sharkbonebroth/li-ion_BMS/li-ion_BMS_PCB/li-ion_BMS_kicadLib/3D/SMD WS2812B Mini.step

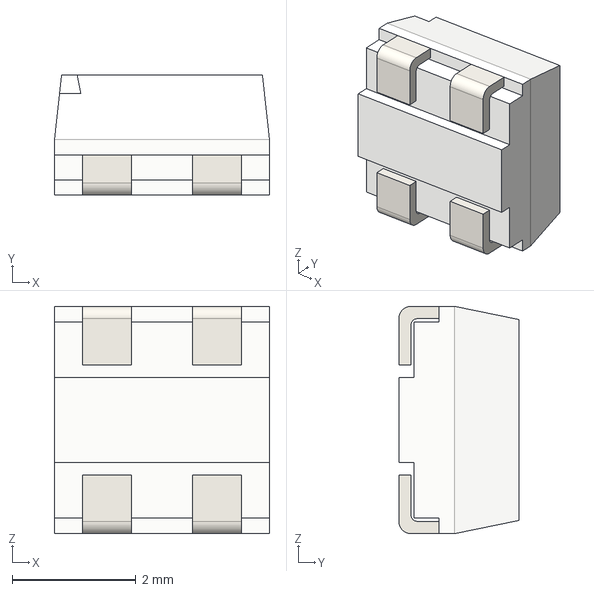
[picture p1: CAD file, 2025-04-25]
li-ion_BMS_PCB/li-ion_BMS_kicadLib/3D/SMD WS2812B Mini.step
3.48 x 1.95 x 3.68 mm
