sharkbonebroth/li-ion_BMS/li-ion_BMS_PCB/li-ion_BMS_PCB.kicad_pcb

## KiCad design li-ion_BMS_PCB/li-ion_BMS_PCB.kicad_pcb (2025-04-29)

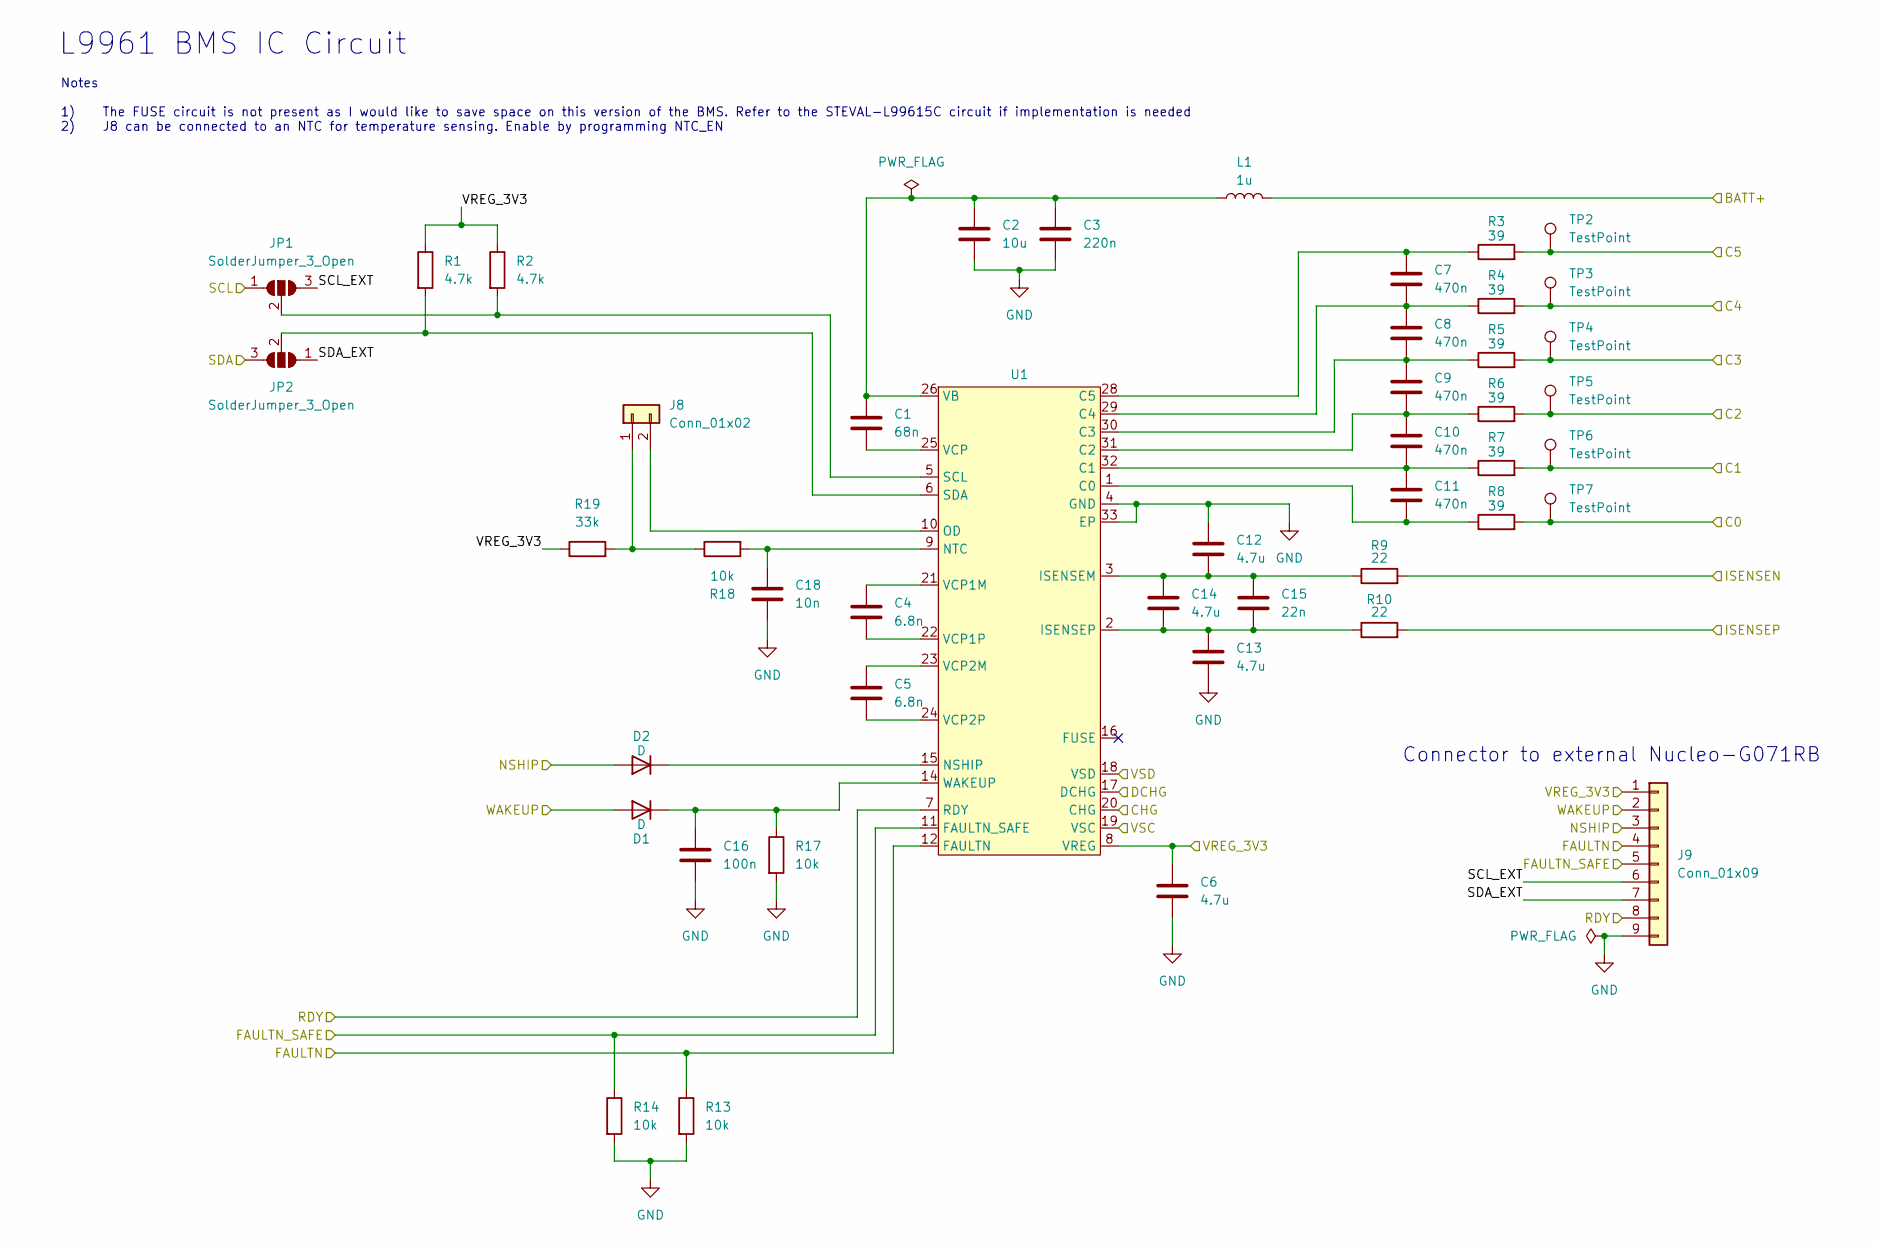
[picture p2: schematic BMS_IC_Circuit.kicad_sch]

Parts:
C1: 68n; C_0603_1608Metric; LCSC C31658
C2: 10u; C_0805_2012Metric; LCSC C440198
C3: 220n; C_0805_2012Metric; LCSC C5378
C4, C5: 6.8n; C_0402_1005Metric; LCSC C1542
C6, C12, C13, C14: 4.7u; C_0603_1608Metric; LCSC C19666
C7, C8, C9, C10, C11: 470n; C_0603_1608Metric; LCSC C1623
C15: 22n; C_0603_1608Metric; LCSC C21122
C16: 100n; C_0603_1608Metric; LCSC C14663
C18: 10n; C_0402_1005Metric; LCSC C15195
D1, D2: D; SS34; LCSC C8678
J8: Conn_01x02; JST_GH_SM02B-GHS-TB_1x02-1MP_P1.25mm_Horizontal; LCSC C189893
J9: Conn_01x09; PinHeader_1x09_P2.54mm_Vertical
JP1, JP2: SolderJumper_3_Open; SolderJumper-3_P1.3mm_Open_Pad1.0x1.5mm_NumberLabels
L1: 1u; L_1008_2520Metric; LCSC C86091
R1, R2: 4.7k; R_0402_1005Metric; LCSC C25900
R3, R4, R5, R6, R7, R8: 39; R_1206_3216Metric; LCSC C22198
R9, R10: 22; R_0603_1608Metric; LCSC C23345
R13, R14, R17, R18: 10k; R_0402_1005Metric; LCSC C25744
R19: 33k; R_0402_1005Metric; LCSC C25779
TP2, TP3, TP4, TP5, TP6, TP7: TestPoint; TestPoint_Pad_D1.0mm
U1: QFN50P500X500X100-33N-D

Connections:
/BMS_IC_Circuit/BATT+: L1.2, U1.19 (VSC); also elsewhere on the board
/BMS_IC_Circuit/C0: R8.2, TP7.1; also elsewhere on the board
/BMS_IC_Circuit/C1: R7.2, TP6.1; also elsewhere on the board
/BMS_IC_Circuit/C2: R6.2, TP5.1; also elsewhere on the board
/BMS_IC_Circuit/C3: R5.2, TP4.1; also elsewhere on the board
/BMS_IC_Circuit/C4: R4.2, TP3.1; also elsewhere on the board
/BMS_IC_Circuit/C5: R3.2, TP2.1; also elsewhere on the board
/BMS_IC_Circuit/CHG: U1.20 (CHG); also elsewhere on the board
/BMS_IC_Circuit/DCHG: U1.17 (DCHG); also elsewhere on the board
/BMS_IC_Circuit/FAULTN: J9.4, R13.1, U1.12 (FAULTN); also elsewhere on the board
/BMS_IC_Circuit/FAULTN_SAFE: J9.5, R14.1, U1.11 (FAULTN_SAFE); also elsewhere on the board
/BMS_IC_Circuit/NSHIP: D2.2 (A), J9.3; also elsewhere on the board
/BMS_IC_Circuit/RDY: J9.8, U1.7 (RDY); also elsewhere on the board
/BMS_IC_Circuit/SCL: JP1.1 (A); also elsewhere on the board
/BMS_IC_Circuit/SCL_EXT: J9.6, JP1.3 (B)
/BMS_IC_Circuit/SDA: JP2.3 (B); also elsewhere on the board
/BMS_IC_Circuit/SDA_EXT: J9.7, JP2.1 (A)
/BMS_IC_Circuit/VREG_3V3: C6.1, J9.1, R1.1, R2.1, R19.1, U1.8 (VREG); also elsewhere on the board
/BMS_IC_Circuit/WAKEUP: D1.2 (A), J9.2; also elsewhere on the board
/Battery_Interfacing_Circuit/CHG/DCHG+: U1.18 (VSD); also elsewhere on the board
/Battery_Interfacing_Circuit/CHG/DCHG-: R10.2; also elsewhere on the board
GND: C2.2, C3.2, C6.2, C12.1, C13.2, C16.2, C18.2, J9.9, R9.2, R13.2, R14.2, R17.2, U1.4 (GND), U1.13 (GND), U1.27 (GND), U1.33 (EP); also elsewhere on the board
unnamed: C16.1, D1.1 (K), R17.1, U1.14 (WAKEUP)
unnamed: D2.1 (K), U1.15 (NSHIP)
unnamed: J8.1, R18.1, R19.2
unnamed: J8.2, U1.10 (OD)
unnamed: JP1.2 (C), R2.2, U1.5 (SCL)
unnamed: JP2.2 (C), R1.2, U1.6 (SDA)
unnamed: C11.2, R8.1, U1.1 (C0)
unnamed: C10.2, C11.1, R7.1, U1.32 (C1)
unnamed: C9.2, C10.1, R6.1, U1.31 (C2)
unnamed: C8.2, C9.1, R5.1, U1.30 (C3)
unnamed: C7.2, C8.1, R4.1, U1.29 (C4)
unnamed: C7.1, R3.1, U1.28 (C5)
unnamed: C12.2, C14.1, C15.1, R9.1, U1.3 (ISENSEM)
unnamed: C13.1, C14.2, C15.2, R10.1, U1.2 (ISENSEP)
unnamed: C18.1, R18.2, U1.9 (NTC)
unnamed: C1.1, C2.1, C3.1, L1.1, U1.26 (VB)
unnamed: C4.1, U1.21 (VCP1M)
unnamed: C4.2, U1.22 (VCP1P)
unnamed: C5.1, U1.23 (VCP2M)
unnamed: C5.2, U1.24 (VCP2P)
unnamed: C1.2, U1.25 (VCP)

Notes on the sheet:
L9961 BMS IC Circuit
Notes 1) The FUSE circuit is not present as I would like to save space on this version of the BMS. Refer to the STEVAL-L99615C circuit if implementation is needed 2) J8 can be connected to an NTC for temperature sensing. Enable by programming NTC_EN
Connector to external Nucleo-G071RB

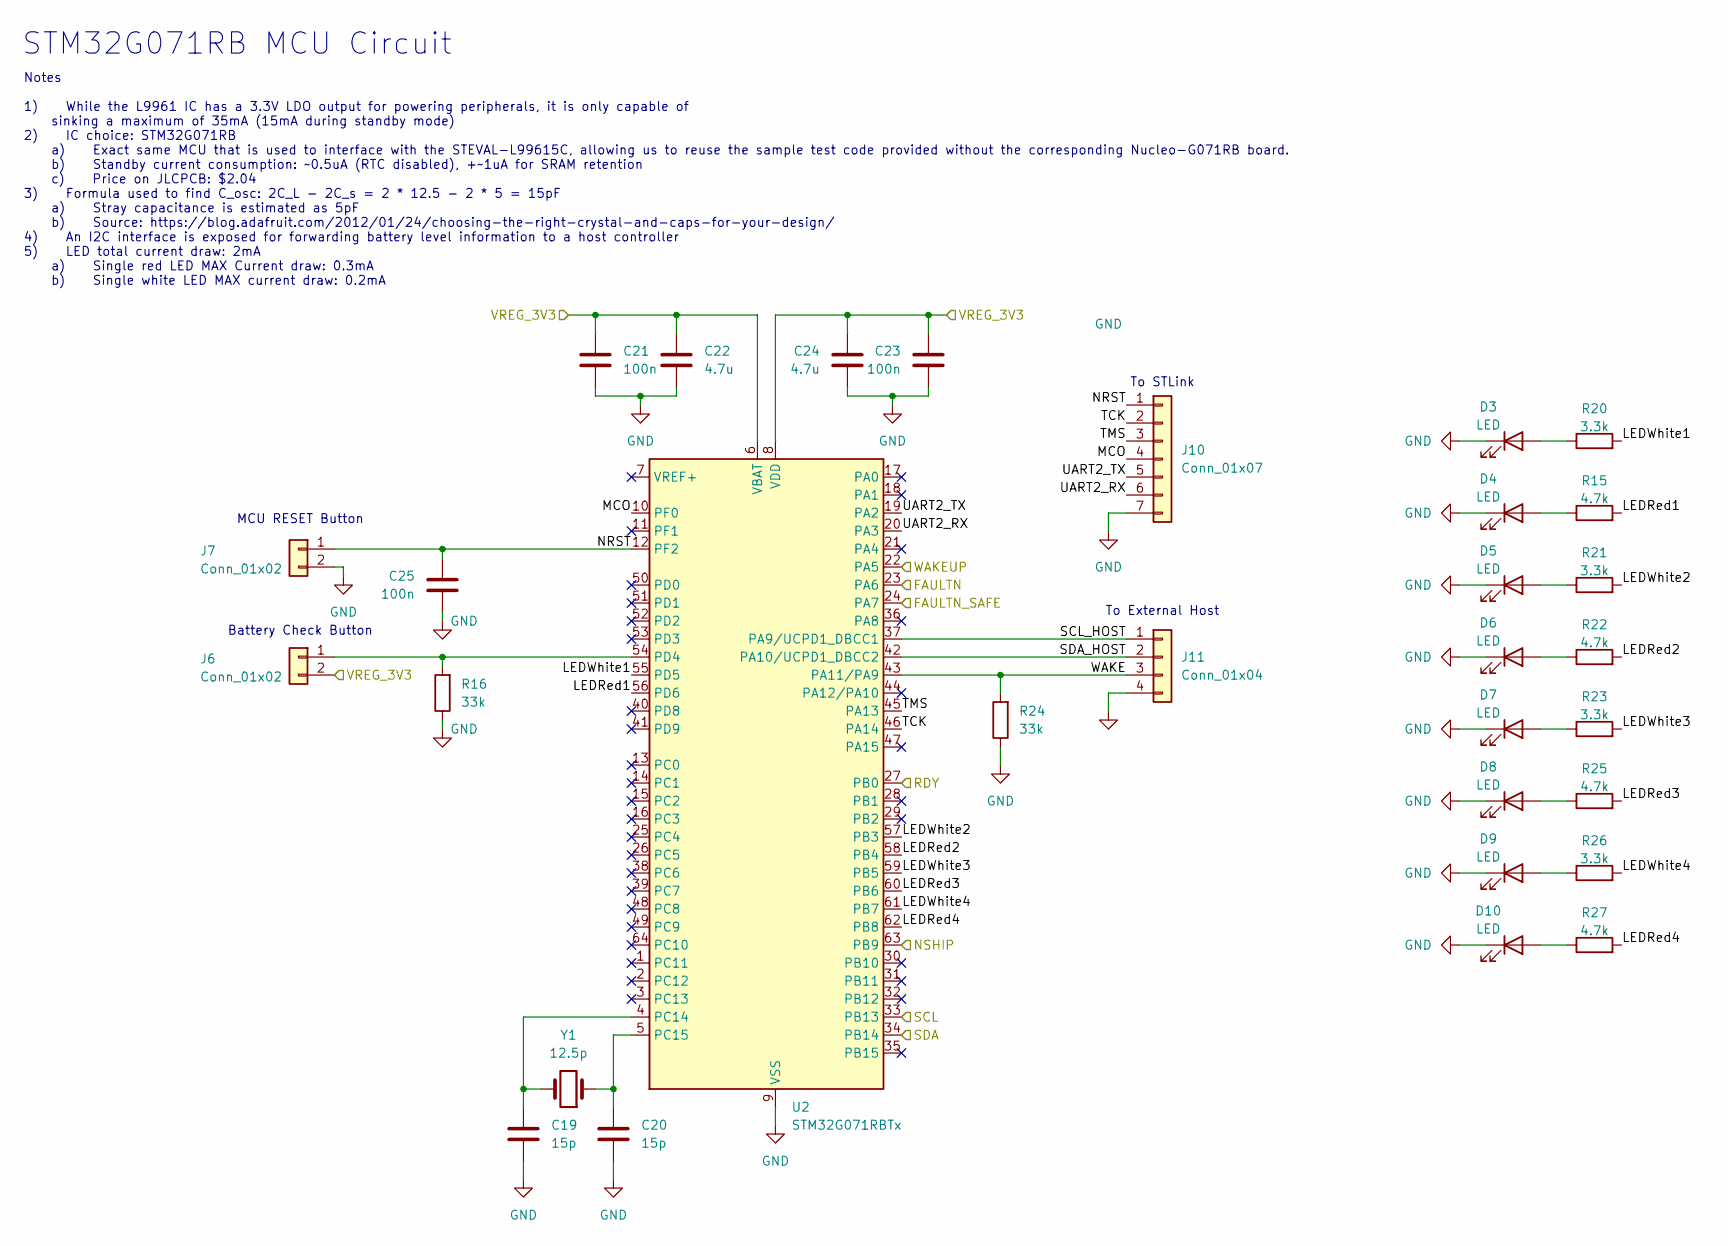
[picture p3: schematic MCU_Circuit.kicad_sch]

Parts:
C19, C20: 15p; C_0603_1608Metric; LCSC C1644
C21, C23, C25: 100n; C_0402_1005Metric; LCSC C1525
C22, C24: 4.7u; C_0603_1608Metric; LCSC C19666
D3, D5, D7, D9: LED; LED_0603_1608Metric; LCSC C2290
D4, D6, D8, D10: LED; LED_0603_1608Metric; LCSC C2286
J6, J7: Conn_01x02; JST_GH_SM02B-GHS-TB_1x02-1MP_P1.25mm_Horizontal; LCSC C189893
J10: Conn_01x07; PinHeader_1x07_P2.54mm_Vertical
J11: Conn_01x04; JST_GH_SM04B-GHS-TB_1x04-1MP_P1.25mm_Horizontal; LCSC C189895
R15, R22, R25, R27: 4.7k; R_0402_1005Metric; LCSC C25900
R16, R24: 33k; R_0402_1005Metric; LCSC C25779
R20, R21, R23, R26: 3.3k; R_0402_1005Metric; LCSC C25890
U2: STM32G071RBTx; LQFP-64_10x10mm_P0.5mm; LCSC C432213
Y1: 12.5p; NX3215SA-32.768K-STD-MUA-8; LCSC C156245

Connections:
/BMS_IC_Circuit/FAULTN: U2.23 (PA6); also elsewhere on the board
/BMS_IC_Circuit/FAULTN_SAFE: U2.24 (PA7); also elsewhere on the board
/BMS_IC_Circuit/NSHIP: U2.63 (PB9); also elsewhere on the board
/BMS_IC_Circuit/RDY: U2.27 (PB0); also elsewhere on the board
/BMS_IC_Circuit/SCL: U2.33 (PB13); also elsewhere on the board
/BMS_IC_Circuit/SDA: U2.34 (PB14); also elsewhere on the board
/BMS_IC_Circuit/VREG_3V3: C21.1, C22.1, C23.1, C24.1, J6.2, U2.6 (VBAT), U2.8 (VDD); also elsewhere on the board
/BMS_IC_Circuit/WAKEUP: U2.22 (PA5); also elsewhere on the board
/MCU_Circuit/LEDRed1: R15.2, U2.56 (PD6)
/MCU_Circuit/LEDRed2: R22.2, U2.58 (PB4)
/MCU_Circuit/LEDRed3: R25.2, U2.60 (PB6)
/MCU_Circuit/LEDRed4: R27.2, U2.62 (PB8)
/MCU_Circuit/LEDWhite1: R20.2, U2.55 (PD5)
/MCU_Circuit/LEDWhite2: R21.2, U2.57 (PB3)
/MCU_Circuit/LEDWhite3: R23.2, U2.59 (PB5)
/MCU_Circuit/LEDWhite4: R26.2, U2.61 (PB7)
/MCU_Circuit/MCO: J10.4, U2.10 (PF0)
/MCU_Circuit/NRST: C25.1, J7.1, J10.1, U2.12 (PF2)
/MCU_Circuit/SCL_HOST: J11.1, U2.37 (PA9/UCPD1_DBCC1)
/MCU_Circuit/SDA_HOST: J11.2, U2.42 (PA10/UCPD1_DBCC2)
/MCU_Circuit/TCK: J10.2, U2.46 (PA14)
/MCU_Circuit/TMS: J10.3, U2.45 (PA13)
/MCU_Circuit/UART2_RX: J10.6, U2.20 (PA3)
/MCU_Circuit/UART2_TX: J10.5, U2.19 (PA2)
/MCU_Circuit/WAKE: J11.3, R24.2, U2.43 (PA11/PA9)
GND: C19.2, C20.2, C21.2, C22.2, C23.2, C24.2, C25.2, D3.1 (K), D4.1 (K), D5.1 (K), D6.1 (K), D7.1 (K), D8.1 (K), D9.1 (K), D10.1 (K), J7.2, J10.7, J11.4, R16.1, R24.1, U2.9 (VSS); also elsewhere on the board
unnamed: D3.2 (A), R20.1
unnamed: D4.2 (A), R15.1
unnamed: D5.2 (A), R21.1
unnamed: D6.2 (A), R22.1
unnamed: D7.2 (A), R23.1
unnamed: D8.2 (A), R25.1
unnamed: D9.2 (A), R26.1
unnamed: D10.2 (A), R27.1
unnamed: J6.1, R16.2, U2.54 (PD4)
unnamed: C19.1, U2.4 (PC14), Y1.2
unnamed: C20.1, U2.5 (PC15), Y1.1

Notes on the sheet:
MCU RESET Button
STM32G071RB MCU Circuit
Battery Check Button
To External Host
To STLink
Notes 1) While the L9961 IC has a 3.3V LDO output for powering peripherals, it is only capable of sinking a maximum of 35mA (15mA during standby mode) 2) IC choice: STM32G071RB a) Exact same MCU that is used to interface with the STEVAL-L99615C, allowing us to reuse the sample test code provided wi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

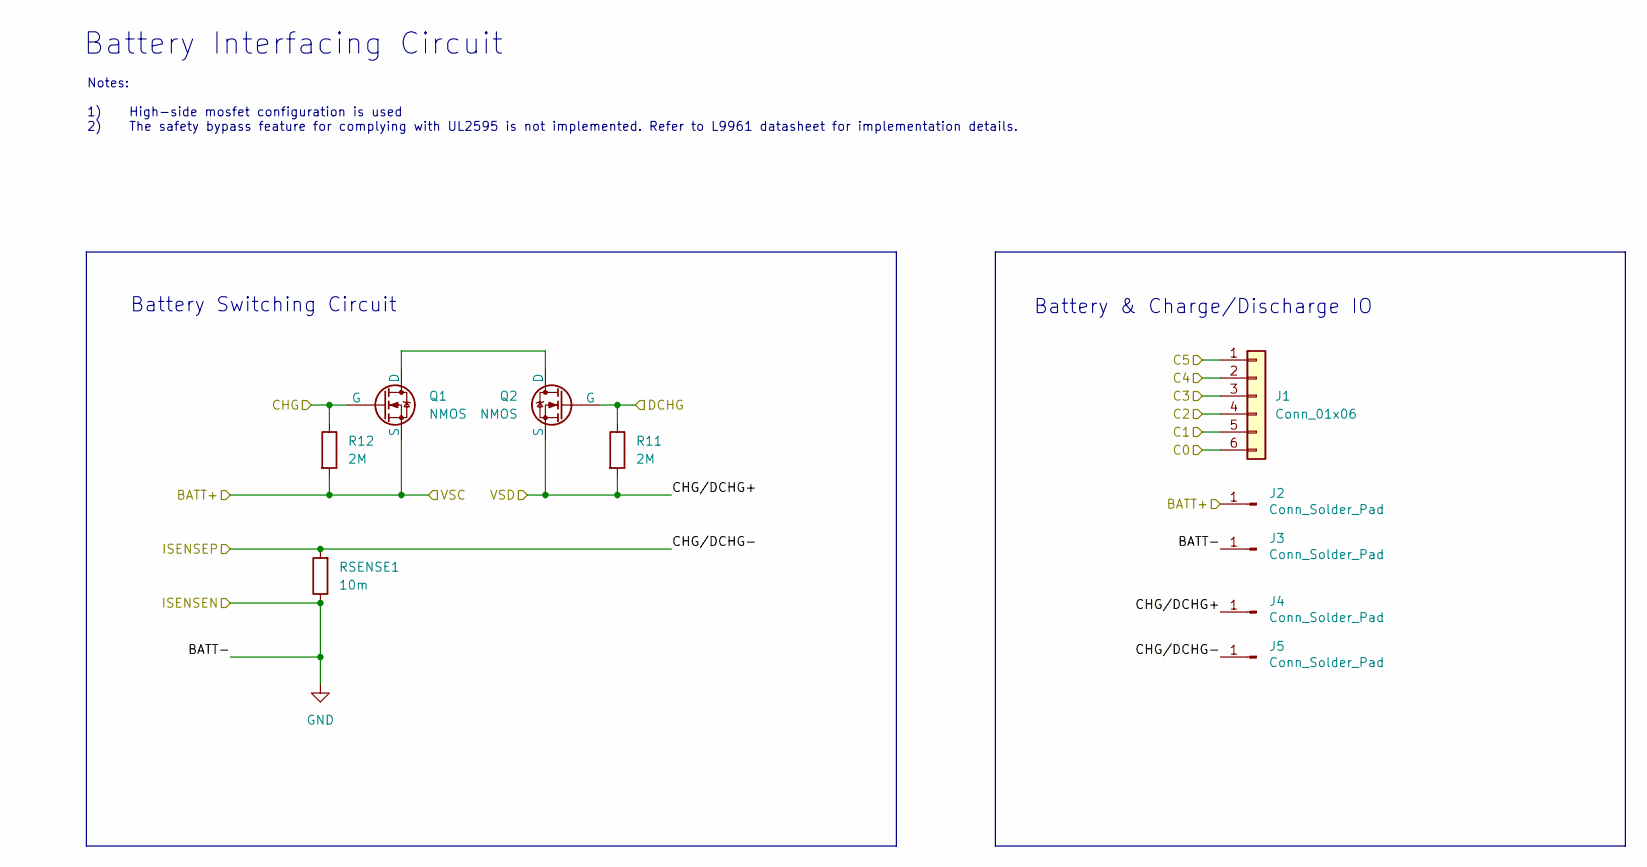
[picture p4: schematic Battery_Interfacing_Circuit.kicad_sch]

Parts:
J1: Conn_01x06; JST_GH_SM06B-GHS-TB_1x06-1MP_P1.25mm_Horizontal; LCSC C133065
J2, J3, J4, J5: Conn_Solder_Pad; SolderWire-0.75sqmm_1x01_D1.25mm_OD2.3mm
Q1, Q2: NMOS; JLCPCB-DFN-8(4.9x5.8); LCSC C78118
R11, R12: 2M; R_0603_1608Metric; LCSC C22976
RSENSE1: 10m; R_2512_6332Metric; LCSC C393072

Connections:
/BMS_IC_Circuit/BATT+: J2.1, Q1.3 (S), R12.2; also elsewhere on the board
/BMS_IC_Circuit/C0: J1.6; also elsewhere on the board
/BMS_IC_Circuit/C1: J1.5; also elsewhere on the board
/BMS_IC_Circuit/C2: J1.4; also elsewhere on the board
/BMS_IC_Circuit/C3: J1.3; also elsewhere on the board
/BMS_IC_Circuit/C4: J1.2; also elsewhere on the board
/BMS_IC_Circuit/C5: J1.1; also elsewhere on the board
/BMS_IC_Circuit/CHG: Q1.2 (G), R12.1; also elsewhere on the board
/BMS_IC_Circuit/DCHG: Q2.2 (G), R11.1; also elsewhere on the board
/Battery_Interfacing_Circuit/CHG/DCHG+: J4.1, Q2.3 (S), R11.2; also elsewhere on the board
/Battery_Interfacing_Circuit/CHG/DCHG-: J5.1, RSENSE1.2; also elsewhere on the board
GND: J3.1, RSENSE1.1; also elsewhere on the board
unnamed: Q1.1 (D), Q2.1 (D)

Notes on the sheet:
Battery Switching Circuit
Notes: 1) High-side mosfet configuration is used 2) The safety bypass feature for complying with UL2595 is not implemented. Refer to L9961 datasheet for implementation details.
Battery Interfacing Circuit
Battery & Charge/Discharge IO

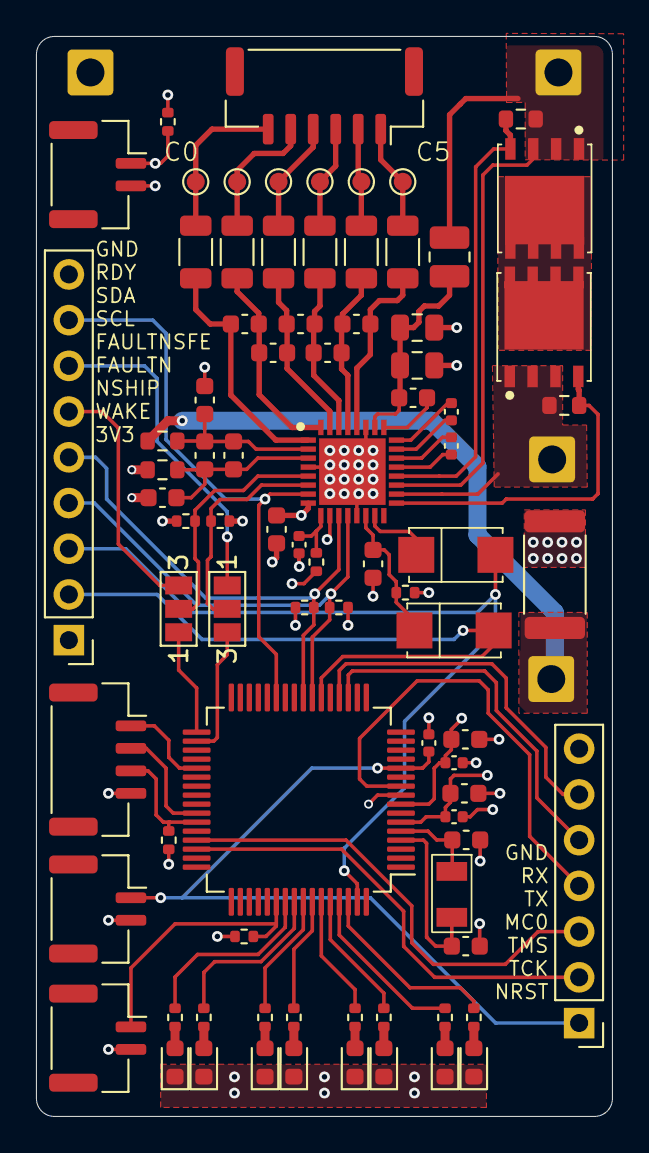
[picture p5: board li-ion_BMS_PCB.kicad_pcb from above]

Board: 4 copper layers, 32.0 x 60.0 mm, 87 parts (0 on the bottom side), 72 nets.
