sharkbonebroth/li-ion_BMS/(commit log)

2025-03-31 finished L9961 Wiring
    [BMS_IC_Circuit.kicad_sch, Battery_Interfacing_Circuit.kicad_sch, MCU_Circuit.kicad_sch, li-ion_BMS_PCB.kicad_pcb, li-ion_BMS_PCB.kicad_sch]
2025-04-29 finished initial V1
    [MCU_Circuit.kicad_sch, li-ion_BMS_PCB.kicad_pcb]
